vegarhatlevik/powerbook-5300-keyboard-controller/hardware/kbd-controller/kbd-controller.kicad_sch

## KiCad design hardware/kbd-controller/kbd-controller.kicad_sch (2026-01-28)

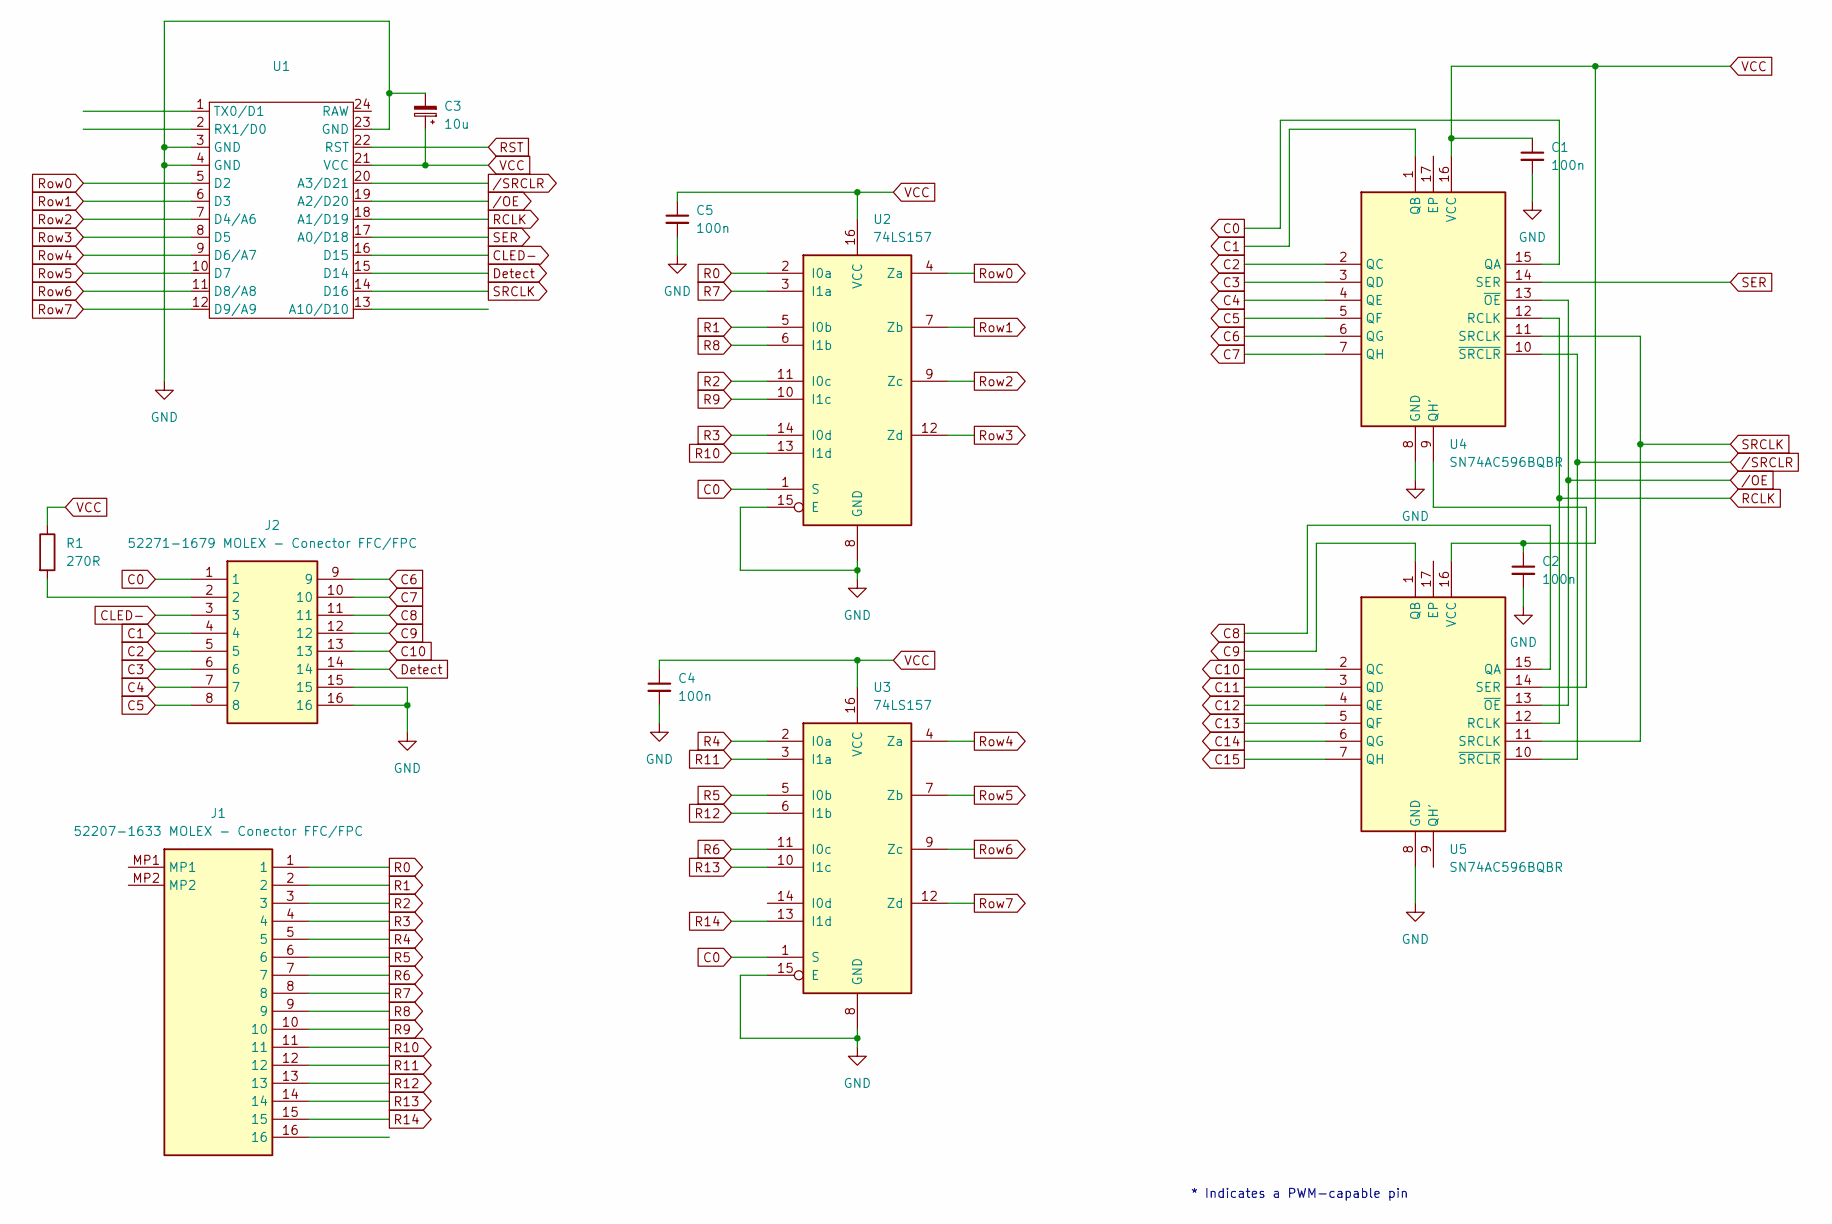
[picture p1: schematic kbd-controller.kicad_sch]

Parts:
C1, C2, C4, C5: 100n; C_Disc_D5.0mm_W2.5mm_P2.50mm
C3: 10u; C_Disc_D5.1mm_W3.2mm_P5.00mm
J1: 52207-1633 MOLEX - Conector FFC/FPC; 52207-1633 MOLEX - Conector FFC_FPC; Manufacturer_Part_Number 52207-1633
J2: 52271-1679 MOLEX - Conector FFC/FPC; 52271-1679 MOLEX - Conector FFC_FPC; Manufacturer_Part_Number 52271-1679
R1: 270R
U1: Pro Micro Leonardo
U2, U3: 74LS157
U4, U5: SN74AC596BQBR; Manufacturer_Part_Number SN74AC596BQBR

Connections:
C0: J2.1, U2.1 (S), U3.1 (S), U4.15 (QA)
C1: J2.4, U4.1 (QB)
C2: J2.5, U4.2 (QC)
C3: J2.6, U4.3 (QD)
C4: J2.7, U4.4 (QE)
C5: J2.8, U4.5 (QF)
C6: J2.9, U4.6 (QG)
C7: J2.10, U4.7 (QH)
C8: J2.11, U5.15 (QA)
C9: J2.12, U5.1 (QB)
C10: J2.13, U5.2 (QC)
C11: U5.3 (QD)
C12: U5.4 (QE)
C13: U5.5 (QF)
C14: U5.6 (QG)
C15: U5.7 (QH)
CLED-: J2.3, U1.16 (D15)
Detect: J2.14, U1.15 (D14)
GND: C1.2, C2.2, C3.2, C4.2, C5.2, J2.15, J2.16, U1.3 (GND), U1.4 (GND), U1.23 (GND), U2.8 (GND), U2.15 (E), U3.8 (GND), U3.15 (E), U4.8 (GND), U5.8 (GND)
unnamed: J2.2, R1.2
unnamed: U4.9 (QH'), U5.14 (SER)
R0: J1.1, U2.2 (I0a)
R1: J1.2, U2.5 (I0b)
R2: J1.3, U2.11 (I0c)
R3: J1.4, U2.14 (I0d)
R4: J1.5, U3.2 (I0a)
R5: J1.6, U3.5 (I0b)
R6: J1.7, U3.11 (I0c)
R7: J1.8, U2.3 (I1a)
R8: J1.9, U2.6 (I1b)
R9: J1.10, U2.10 (I1c)
R10: J1.11, U2.13 (I1d)
R11: J1.12, U3.3 (I1a)
R12: J1.13, U3.6 (I1b)
R13: J1.14, U3.10 (I1c)
R14: J1.15, U3.13 (I1d)
RCLK: U1.18 (A1/D19), U4.12 (RCLK), U5.12 (RCLK)
RST: U1.22 (RST)
Row0: U1.5 (D2), U2.4 (Za)
Row1: U1.6 (D3), U2.7 (Zb)
Row2: U1.7 (D4/A6), U2.9 (Zc)
Row3: U1.8 (D5), U2.12 (Zd)
Row4: U1.9 (D6/A7), U3.4 (Za)
Row5: U1.10 (D7), U3.7 (Zb)
Row6: U1.11 (D8/A8), U3.9 (Zc)
Row7: U1.12 (D9/A9), U3.12 (Zd)
SER: U1.17 (A0/D18), U4.14 (SER)
SRCLK: U1.14 (D16), U4.11 (SRCLK), U5.11 (SRCLK)
VCC: C1.1, C2.1, C3.1, C4.1, C5.1, R1.1, U1.21 (VCC), U2.16 (VCC), U3.16 (VCC), U4.16 (VCC), U5.16 (VCC)
/OE: U1.19 (A2/D20), U4.13 (~OE), U5.13 (~OE)
/SRCLR: U1.20 (A3/D21), U4.10 (~SRCLR), U5.10 (~SRCLR)

Notes on the sheet:
* Indicates a PWM-capable pin
