vegarhatlevik/powerbook-5300-keyboard-controller/(commit log)

2026-01-22 Multiplexing rows 1-7 to save on input lines on the microcontroller. Using column 1 select to choose betwen rows 1-7 or 8-14.
    [kbd-controller.kicad_sch]
2026-01-28 Fixed a bug due to incorrectly shaped arrays.
    [kbd-controller.kicad_sch]
